AdamsLab01/MailboxNotifyv2.0/Schematic.pdf

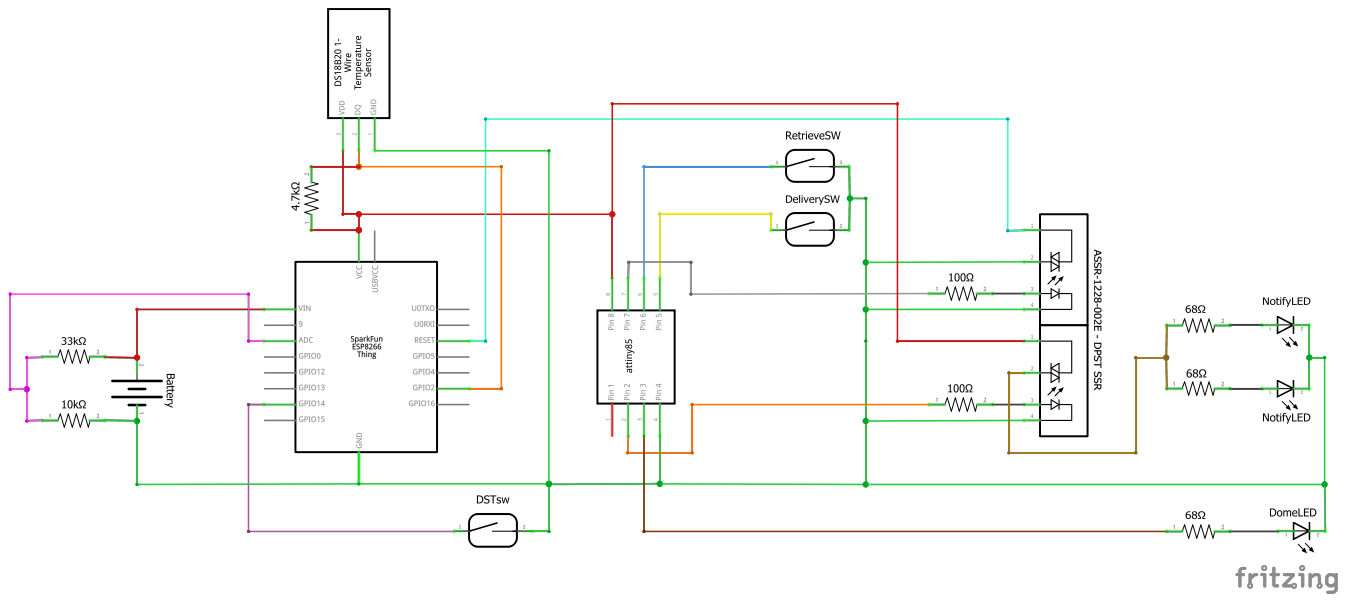
[picture p1: page 1]
